lucym202/N10-LED-Buffer/images/board-front.jpg

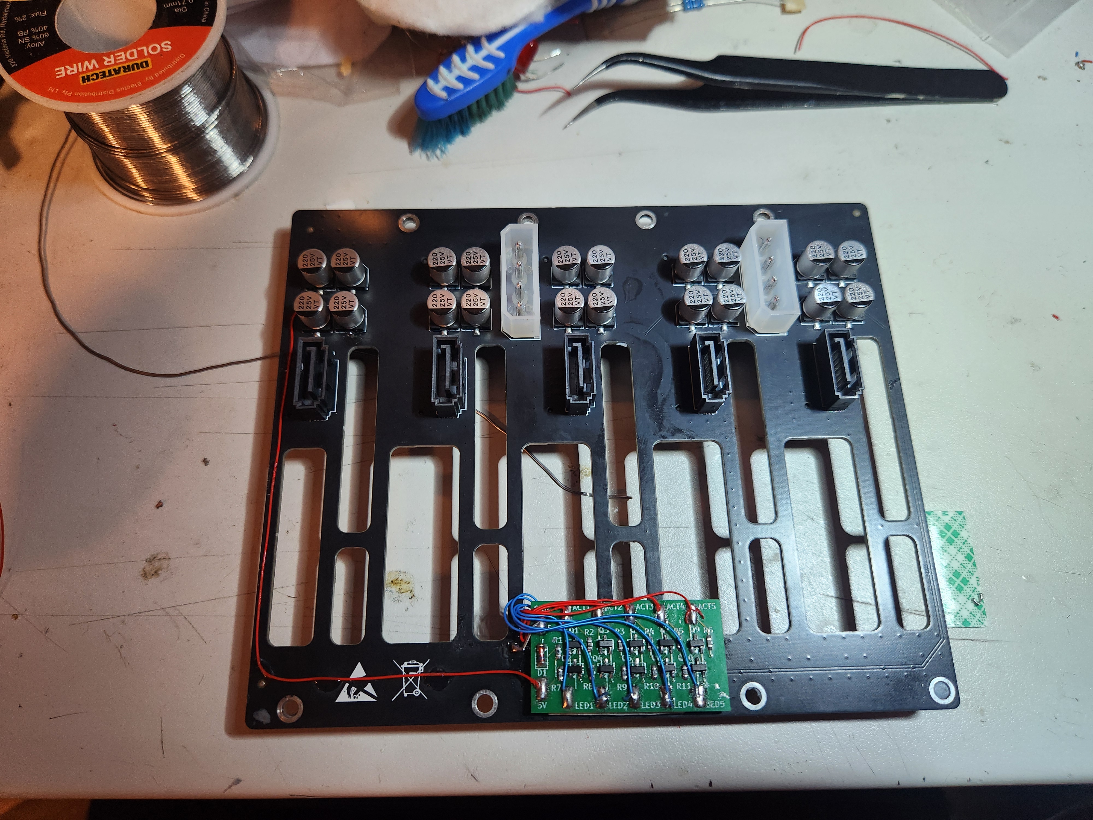
images/board-front.jpg
