lucym202/N10-LED-Buffer/images/board-rear.jpg

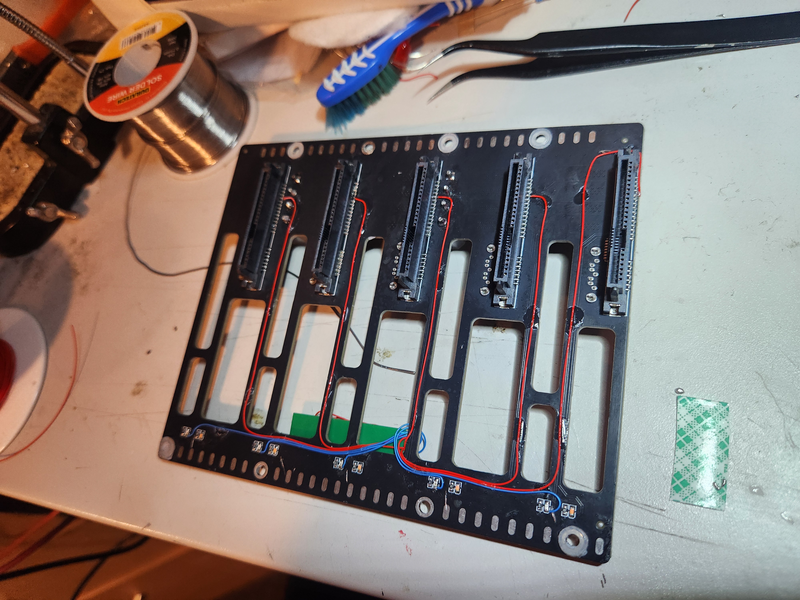
images/board-rear.jpg
