lucym202/N10-LED-Buffer/SAS activity indicator.kicad_pcb

## KiCad design SAS activity indicator.kicad_pcb (2026-10-14)

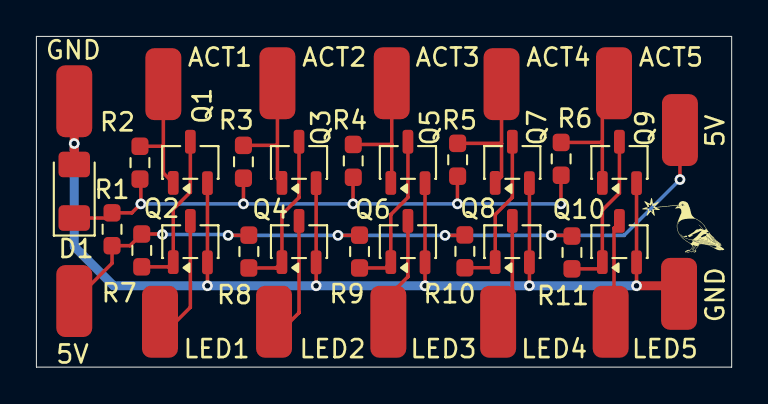
[picture p3: board SAS activity indicator.kicad_pcb from above]

Board: 2 copper layers, 38.6 x 18.4 mm, 36 parts (0 on the bottom side), 18 nets.

Parts:
5V, 5V#2: +5V; SolderWirePad_1x01_SMD_2x4mm
ACT1: SAS_ACT1; SolderWirePad_1x01_SMD_2x4mm
ACT2: SAS_ACT2; SolderWirePad_1x01_SMD_2x4mm
ACT3: SAS_ACT3; SolderWirePad_1x01_SMD_2x4mm
ACT4: SAS_ACT4; SolderWirePad_1x01_SMD_2x4mm
ACT5: SAS_ACT5; SolderWirePad_1x01_SMD_2x4mm
D1: 3.3V; D_1206_3216Metric_Pad1.42x1.75mm_HandSolder
GND: GND; SolderWirePad_1x01_SMD_2x4mm
GND#2: GND; SolderWirePad_1x01_SMD_2x4mm
LED1: LED1; SolderWirePad_1x01_SMD_2x4mm
LED2: LED2; SolderWirePad_1x01_SMD_2x4mm
LED3: LED3; SolderWirePad_1x01_SMD_2x4mm
LED4: LED4; SolderWirePad_1x01_SMD_2x4mm
LED5: LED5; SolderWirePad_1x01_SMD_2x4mm
Q1, Q2, Q3, Q4, Q5, Q6, Q7, Q8, Q9, Q10: BC847B; SOT-23-3-CESWAP
R1: 470; R_0603_1608Metric_Pad0.98x0.95mm_HandSolder
R2, R3, R4, R5, R6: 12K; R_0603_1608Metric_Pad0.98x0.95mm_HandSolder
R7, R8, R9, R10, R11: 10K; R_0603_1608Metric_Pad0.98x0.95mm_HandSolder

Connections:
+3V3: D1.1 (K), R1.2, R2.2, R3.2, R4.2, R5.2, R6.2
+5V: 5V.1, 5V#2.1, R1.1, R7.1, R8.1, R9.1, R10.1, R11.1
GND: D1.2 (A), GND.1, GND#2.1, Q1.3 (E), Q2.3 (E), Q3.3 (E), Q4.3 (E), Q5.3 (E), Q6.3 (E), Q7.3 (E), Q8.3 (E), Q9.3 (E), Q10.3 (E)
unnamed: ACT1.1, Q1.1 (B), R2.1
unnamed: ACT2.1, Q3.1 (B), R3.1
unnamed: ACT3.1, Q5.1 (B), R4.1
unnamed: ACT4.1, Q7.1 (B), R5.1
unnamed: ACT5.1, Q9.1 (B), R6.1
unnamed: LED1.1, Q2.2 (C)
unnamed: LED2.1, Q4.2 (C)
unnamed: LED3.1, Q6.2 (C)
unnamed: LED4.1, Q8.2 (C)
unnamed: LED5.1, Q10.2 (C)
unnamed: Q1.2 (C), Q2.1 (B), R7.2
unnamed: Q3.2 (C), Q4.1 (B), R8.2
unnamed: Q5.2 (C), Q6.1 (B), R9.2
unnamed: Q7.2 (C), Q8.1 (B), R10.2
unnamed: Q9.2 (C), Q10.1 (B), R11.2
