lucym202/N10-LED-Buffer/(commit log)

2026-10-14 Initial upload
    [SAS activity indicator.kicad_pcb, SAS activity indicator.kicad_sch]
2026-10-17 Add README.md for N10 LED Buffer
2026-10-17 Add bench testing guide to README (PCB pre-install tests and expected measurements)
2026-10-17 Revise installation steps for LED wiring
    Updated installation instructions to reflect changes in the number of copper traces and soldering steps.
2026-10-17 Revise wire type and hand-soldering instructions
    Updated wire specifications and soldering instructions for clarity.
2026-10-17 Update soldering iron specifications in README
2026-10-17 Update troubleshooting section in README
    Added troubleshooting steps for LED behavior with drives.
2026-10-17 Revise wiring instructions and add testing steps
    Updated instructions for connecting GND and 5V pads, and added steps for testing and securing wiring.
2026-10-17 Update README with new required parts list
    Added additional required parts for soldering components.
2026-10-17 docs: normalize unit spacing/case and add clarity (required skills, power-supply warning)
2026-10-17 Revise README for clarity and detail improvements
    Updated README to clarify instructions and specifications for the N10 LED buffer add-on.
2026-10-17 Revise hand-soldering instructions in README
    Updated hand-soldering instructions for clarity and left-handed preference.
2026-10-17 Fix soldering instructions for ACT and LED pads
    Corrected the orientation instructions for soldering the ACT pads and LED pads.
2026-10-17 Add foam tape to materials list in README
2026-10-17 Clarify LED cathode reference in installation steps
2026-10-18 Revise README for clarity on soldering and testing
    Updated instructions for connecting ACT and LED pads, clarified verification steps, and improved soldering guidance.
